catavoicu/Stabilizator-de-tensiune-cu-Element-de-Reglaj-Serie-ERS-/Layout/p1_voicu_catalin.jpg

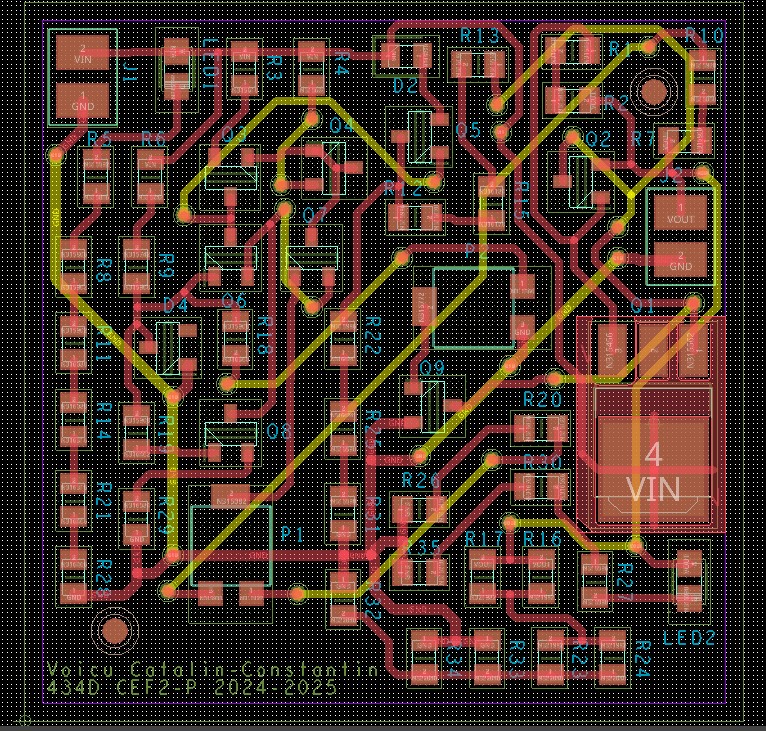
Layout/p1_voicu_catalin.jpg
