catavoicu/Stabilizator-de-tensiune-cu-Element-de-Reglaj-Serie-ERS-/P1_2024_434D_Voicu_Catalin_Constantin_SERS_N28.pptx

## Circuite Electronice Fundamentale 2 – Proiect (CEF2-Pr)

Tema: Stabilizator de tensiune cu Element de Reglaj Serie (ERS)

Student: Voicu Cătălin-Constantin
Grupa 434D

## Date de proiectare

- Tensiunea de ieșire reglabilă în intervalul: 14 - 28 [V]
- Element de reglaj serie;
- Sarcina la ieșire 1120Ω;
- Protecție la suprasarcină prin limitarea temperaturii tranzistorului regulator serie la 120⁰C, și a curentului maxim la 0,5A;
- Tensiune de intrare în intervalul:50,4 - 56 [V]
- Domeniul temperaturilor de funcționare: 0-60 ⁰C (verificabil prin testare în temperatură);
- Dimensiunile PCB: 40mm x 40mm;
- Pentru traseele de interconectare se dau următoarele lăţimi:
  I. Curent de 1A - 26 mil;
  II. Curent de sute de mA - 18 mil;
  III. Semnal - 20 mil.
- Material FR4, dublu strat;

## Schema bloc

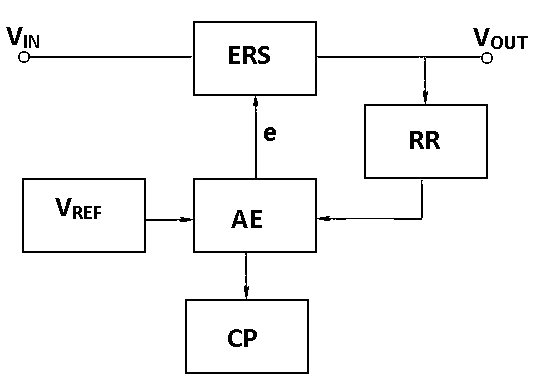
[picture p2: figure]

1. Tensiunea de referință (REF)
2. Amplificatorul de eroare (AE)
3. Elementul de Reglaj Serie (ERS)
4. Rețeaua de reacție (RR)
5. Cicuitele de Protecție (CP)

## Schema electrică

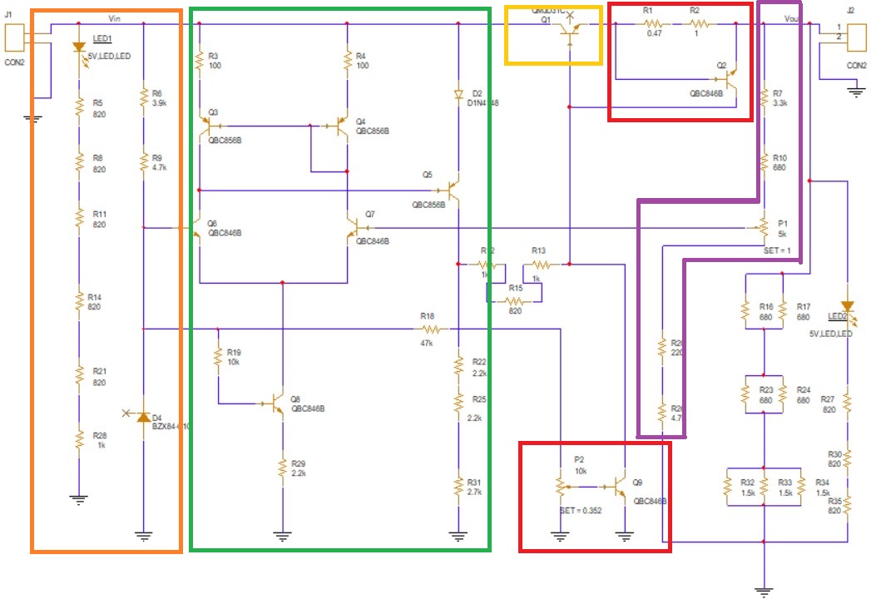
[picture p3: figure]
A diagram of a circuit board

1. Tensiunea de referință (REF)
2. Amplificatorul de eroare (AE)
3. Elementul de Reglaj Serie (ERS)
4. Rețeaua de reacție (RR)
5. Cicuitele de Protecție (CP)

## Simulări

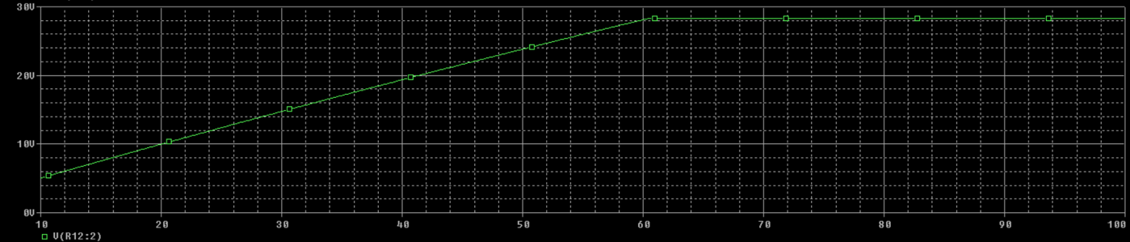
[picture p4: figure]

Caracteristica de ieșire în funcție de tensiunea de intrare

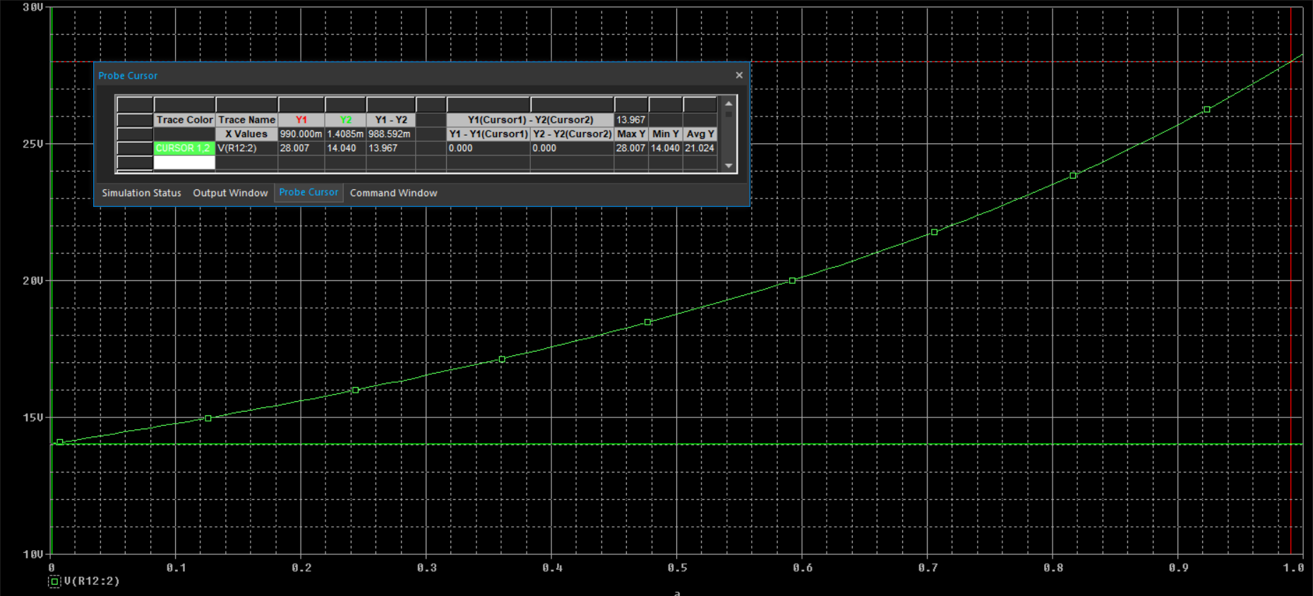
[picture p5: figure]

Caracteristica de ieșire în funcție de poziția potențiometrului

## Simulări

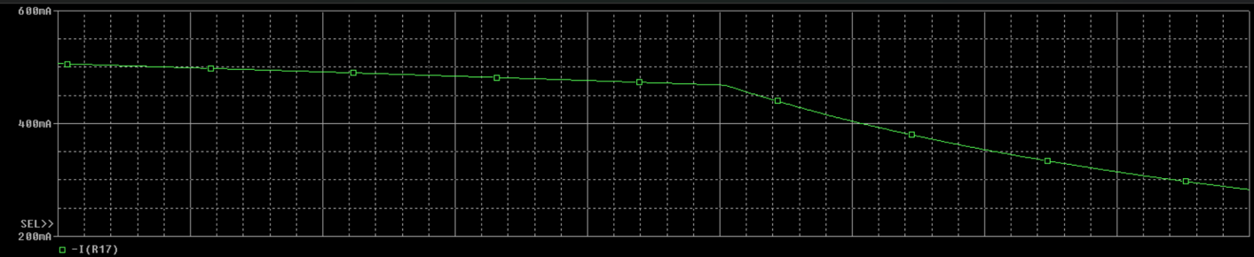
[picture p6: figure]
A graph with green lines

Protecția la suprasarcină

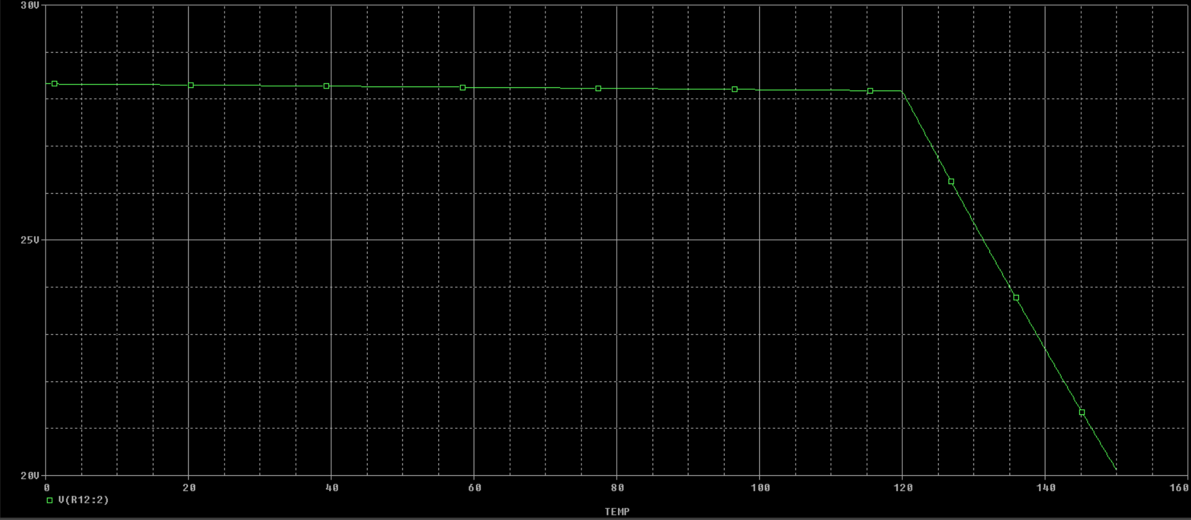
[picture p7: figure]

Protecția la temperatură

## Layout

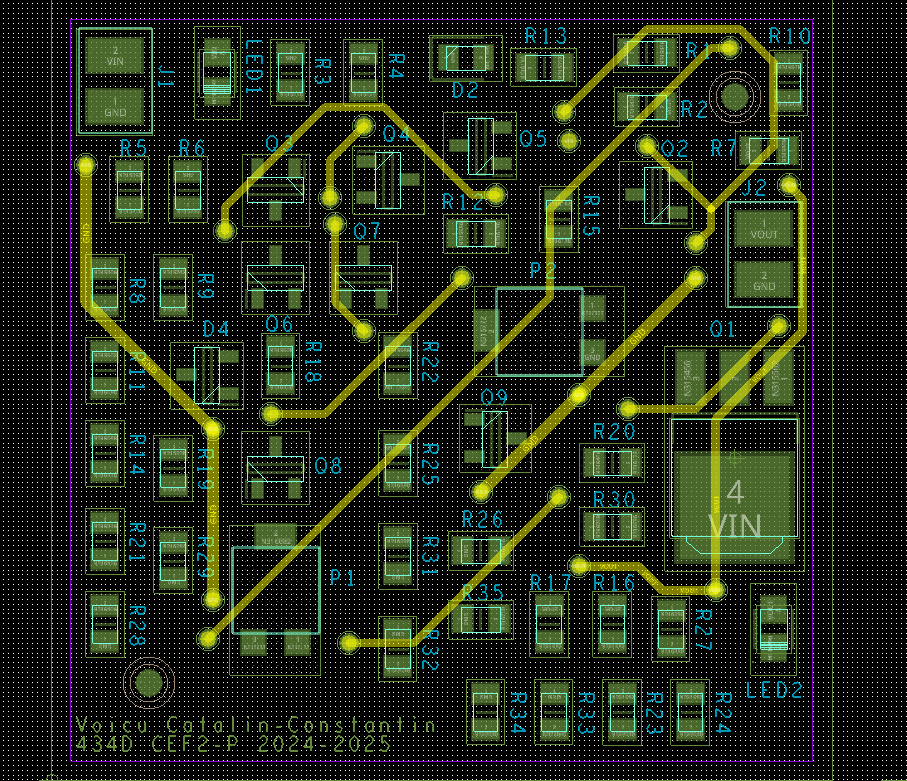
[picture p8: figure]
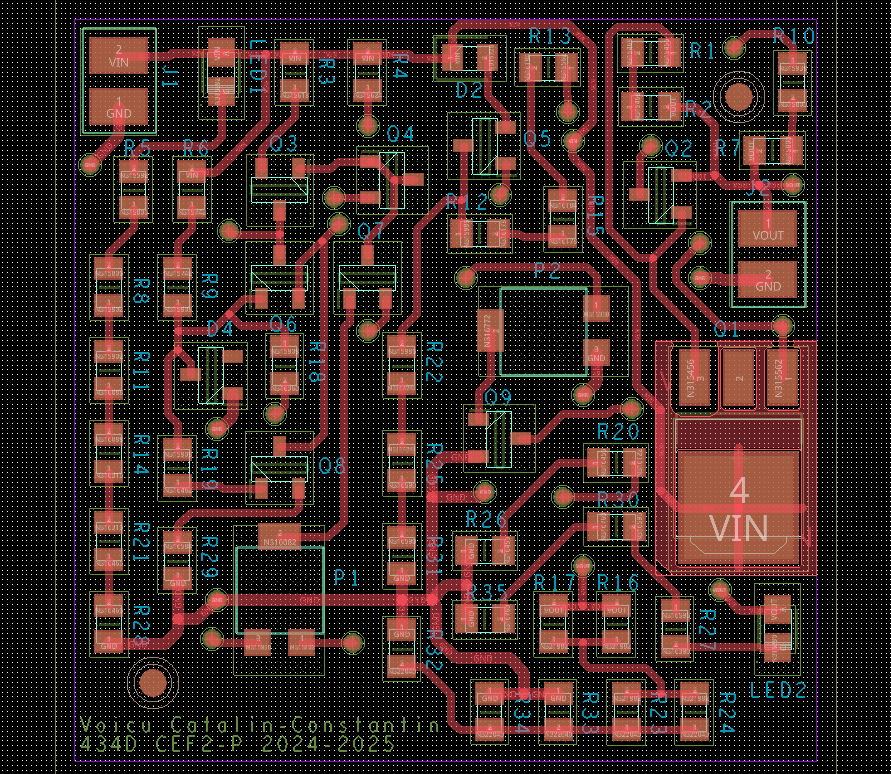
[picture p9: figure]
A computer circuit board with many small colored lines

## Fotografii din etapa de echipare a modulului electronic

- Layout PCB
- Foto PCB echipat
- Maxim o pagină

- se va completa în Sem. al II-lea

## Rezultate experimentale

- Foto forme de undă
- Tabele măsurători
- Tot ceea ce justifică funcționarea proiectului în specificațiile impuse
- Maxim două pagini

- se va completa în Sem. al II-lea

## Rezultate experimentale

- Tabel comparativ

Cerințe impuse | Rezultate simulări | Rezultate măsurători

- se va completa în Sem. al II-lea

## Concluzii

- Se comentează rezultatele obținute
- Ce îmbunătățiri ar putea fi aduse
- În cazul în care proiectul nu a funcționat la prima încercare, se scot în evidență erorile de concept/realizare (d.p.d.v al proiectării schemei, layout-ului, etc. )
- Cum ar putea fi depanat – plan de depanare (organigramă)
- Maxim două pagini
- ! Timpul maxim acordat expunerii este de 5-6 minute

- se va completa în Sem. al II-lea

## Concluzii

- Ce cunoștințe au fost dobândite pe parcursul activităților desfășurate în cadrul proiectului
- Evidențiați, dacă există, părțile bune legate de activitatea depusă și/ sau precizați părțile slabe existente în organizarea desfășurării proiectului
- Care ar fi propunerea voastră, privind modul în care ar trebui să se desfășoare activitățile cerute de proiect, pentru a se asigura finalizarea sa. Prezentați diagrama Gantt corespunzătoare.
- Maxim două pagini
- ! Timpul maxim acordat expunerii este de 5-6 minute

- se va completa în Sem. al II-lea

## Discipline studiate utile în realizarea proiectului

- Se trec disciplinele din care au fost utilizate cunoștințe/informații pentru realizarea proiectului
- Ce discipline, aflate în semestrele din amonte, ar fi trebuit să fie mai bine însușite pentru ușurarea realizării activităților conexe proiectului?

- se va completa în Sem. al II-lea
