catavoicu/Stabilizator-de-tensiune-cu-Element-de-Reglaj-Serie-ERS-/Proiect docs/psf.pdf

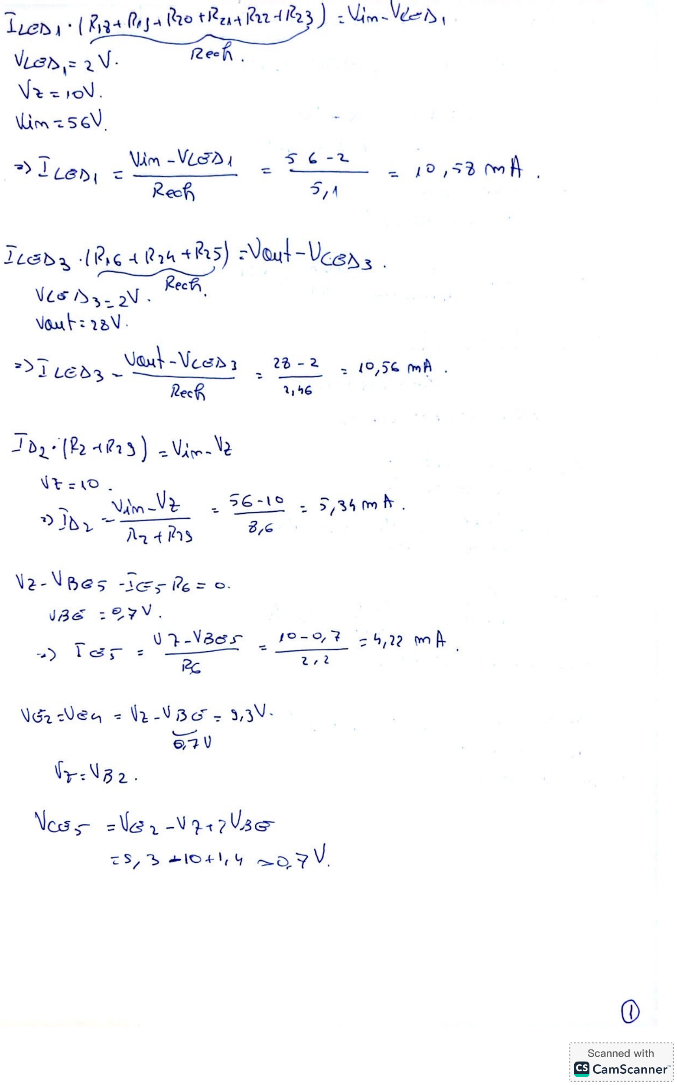
[picture p28: page 1]
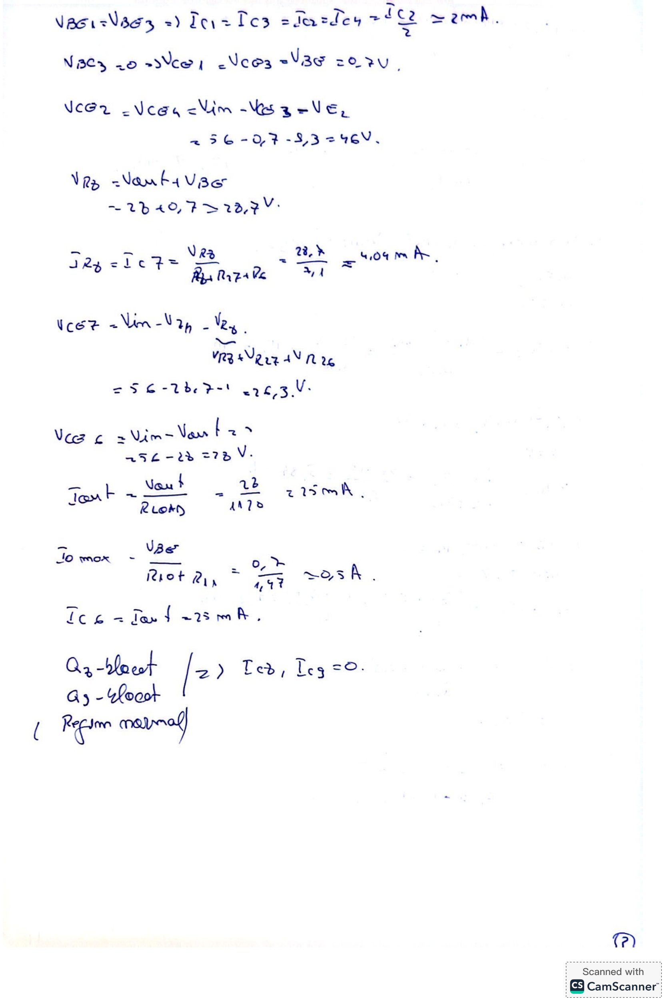
[picture p29: page 2]
