catavoicu/Stabilizator-de-tensiune-cu-Element-de-Reglaj-Serie-ERS-/Schematics/P1_VOICU_CATALIN.jpg

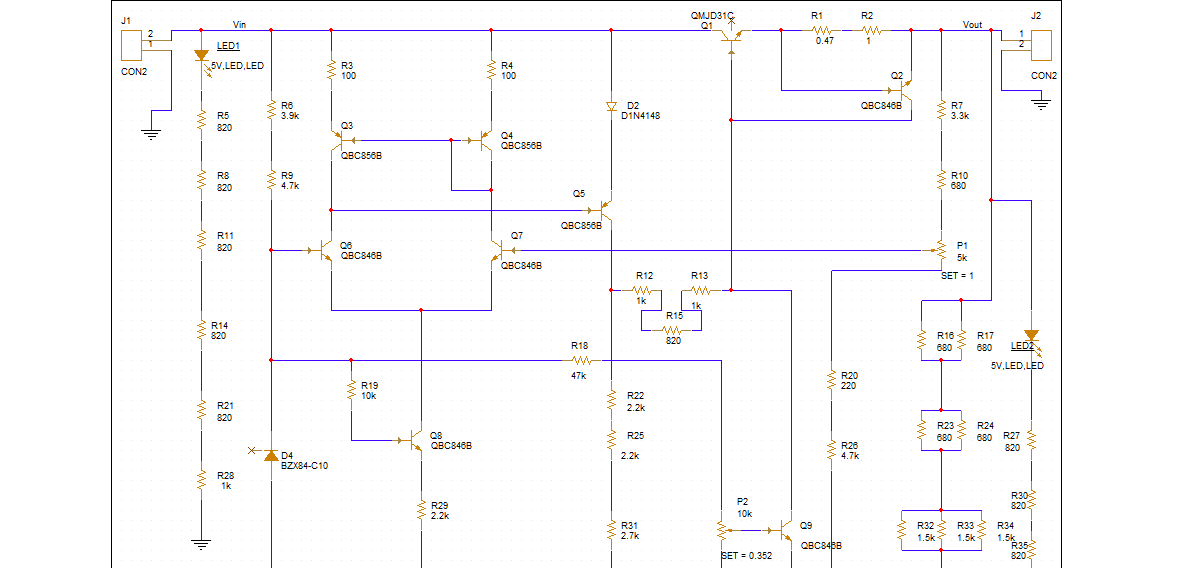
Schematics/P1_VOICU_CATALIN.jpg
