catavoicu/Stabilizator-de-tensiune-cu-Element-de-Reglaj-Serie-ERS-/Schematics/Schema.jpg

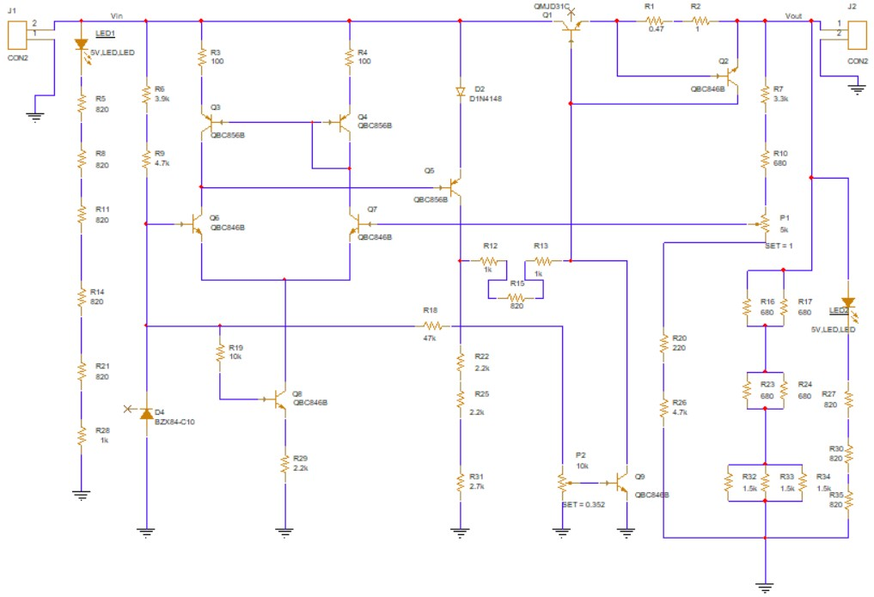
Schematics/Schema.jpg
