catavoicu/Stabilizator-de-tensiune-cu-Element-de-Reglaj-Serie-ERS-/Schematics/Schematics_sapt7/P1_VOICU_CATALIN.png

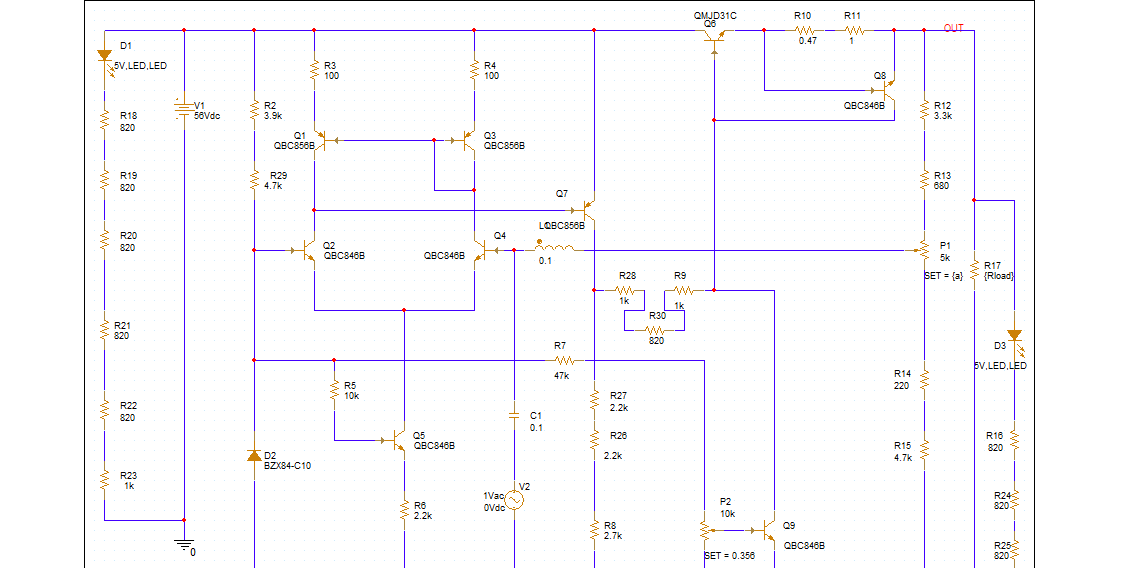
Schematics/Schematics_sapt7/P1_VOICU_CATALIN.png
