catavoicu/Stabilizator-de-tensiune-cu-Element-de-Reglaj-Serie-ERS-/Schematics/Schematics_sapt7/P1_Voicu_Catalin_Constantin.jpg

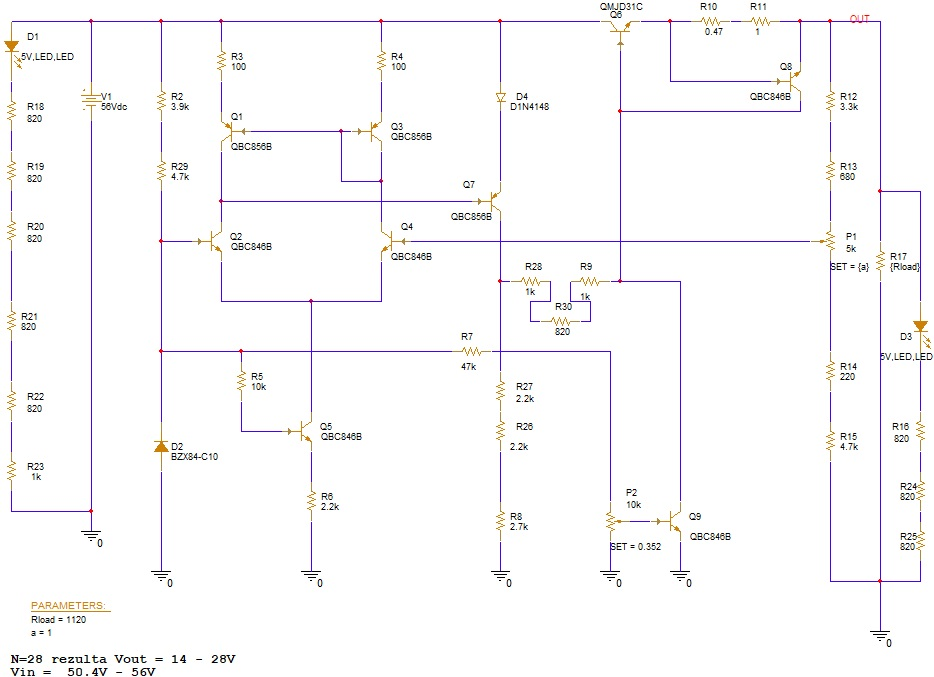
Schematics/Schematics_sapt7/P1_Voicu_Catalin_Constantin.jpg
