catavoicu/Stabilizator-de-tensiune-cu-Element-de-Reglaj-Serie-ERS-/Bill_of_Materials/Anexa_a1_Grupa_434D.xls

Anexa a1 - Grupa 434D - Tema 3 - Stabilizator de tensiune cu ERS
Nr. Crt. | Nume | Catalog | Cod distrib | Nume prod | Prod | Clasă | Qty fix | Qty final | Qty min | Descriere | Distribuitor | Pret (fara TVA) referinta/buc. TME România | Pret total pe reper (fara TVA) - propus
1 | 0 ohm | (LINK) (http://www.tme.eu/ro/details/smd1206-0r/rezistente-smd-1206/royal-ohm/1206s4j0000t5e/) | 1206S4J0000T5E | 1206S4J0000T5E | SR PASSIVES | rezistor | 0 |  |  | Rezistor: thick film; SMD; 1206; 0Ω; 0,25W; ±5%; -55÷125°C | TME România | 0.03841 | 0
2 | 0.47 | (LINK) (http://www.tme.eu/ro/details/smd0805-0r47/rezistente-smd-0805/royal-ohm/0805s8j047kt5e/) | SMD0805-0R47 | 0805S8J047KT5E | ROYAL OHM | rezistor | 20 |  | 1 | Rezistor SMD, chip, 0805, 0.47Ω, ±5%, 0.125W | TME România | 0.01454 | 0.2908
3 | 1 | (LINK) (https://www.tme.eu/ro/details/smd0805-1r/rezistente-smd-0805/royal-ohm/0805s8j010jt5e/) | SMD0805-1R-5% | 0805S8J010JT5E | ROYAL OHM | rezistor | 20 |  | 1 | Rezistor SMD, chip, 0805, 1Ω, ±5%, 0.125W | TME România | 0.01723 | 0.3446
4 | 4.7 | (LINK) (https://www.tme.eu/ro/details/smd0805-4r7/rezistente-smd-0805/royal-ohm/0805s8j047jt5e/) | SMD0805-4R7-5% | 0805S8J047JT5E | ROYAL OHM | rezistor | 10 |  |  | Rezistor SMD, chip, 0805, 4.7Ω, ±5%, 0.125W | TME România | 0.01723 | 0.1723
5 | 10 | (LINK) (https://www.tme.eu/ro/details/smd0805-10r/rezistente-smd-0805/royal-ohm/0805s8j0100t5e/) | SMD0805-10R-5% | 0805S8J0100T5E | ROYAL OHM | rezistor | 10 |  |  | Rezistor SMD, chip, 0805, 10Ω, ±5%, 0.125W | TME România | 0.01723 | 0.1723
6 | 22 | (LINK) (https://www.tme.eu/ro/details/smd0805-22r-1%25/rezistente-smd-0805/royal-ohm/0805s8f220jt5e/) | SMD0805-22R-1% | 0805S8F220JT5E | ROYAL OHM | rezistor | 20 |  |  | Rezistor SMD, chip, 0805, 22Ω, ±1%, 0.125W | TME România | 0.02127 | 0.4254
7 | 33 | (LINK) (https://www.tme.eu/ro/details/smd0805-33r/rezistente-smd-0805/royal-ohm/0805s8j0330t5e/) | SMD0805-33R-5% | 0805S8J0330T5E | ROYAL OHM | rezistor | 20 |  |  | Rezistor SMD, chip, 0805, 33Ω, ±5%, 0.125W | TME România | 0.01723 | 0.3446
8 | 51 | (LINK) (http://www.tme.eu/ro/details/rc0805jr-0751r/rezistente-smd-0805/yageo/rc0805jr-0751rl/) | SMD0805-51R-5% | 0805S8J0510T5E | ROYAL OHM | rezistor | 40 |  |  | Rezistor SMD, chip, 0805, 51Ω, ±5%, 0.125W | TME România | 0.0261 | 1.044
9 | 68 | (LINK) (http://www.tme.eu/ro/details/smd0805-68r-1%25/rezistente-smd-0805/royal-ohm/0805s8f680jt5e/) | SMD0805-68R-1% | 0805S8F680JT5E | ROYAL OHM | rezistor | 10 |  |  | Rezistor SMD, chip, 0805, 68Ω, ±1%, 0.125W | TME România | 0.04662 | 0.4662
10 | 82 | (LINK) (https://www.tme.eu/ro/details/wf08p-82r-5%25/rezistente-smd-0805/walsin/wf08p820jtl/) | SMD0805-82R-5% | WF08P820JTL | WALSIN | rezistor | 20 |  |  | Rezistor SMD, chip, 0805, 82Ω, ±5%, 0.125W | TME România | 0.0172 | 0.344
11 | 100 | (LINK) (https://www.tme.eu/ro/details/smd0805-100r/rezistente-smd-0805/royal-ohm/0805s8j0101t5e/) | SMD0805-100R-5% | 0805S8J0101T5E | ROYAL OHM | rezistor | 60 |  | 2 | Rezistor SMD, chip, 0805, 100Ω, ±5%, 0.125W | TME România | 0.01723 | 1.0338
12 | 150 | (LINK) (https://www.tme.eu/ro/details/smd0805-150r/rezistente-smd-0805/royal-ohm/0805s8j0151t5e/) | SMD0805-150R-5% | 0805S8F1500T5E | ROYAL OHM | rezistor | 30 |  |  | Rezistor SMD, chip, 0805, 150Ω, ±5%, 0.125W | TME România | 0.01723 | 0.5169
13 | 220 | (LINK) (http://www.tme.eu/ro/details/smd0805-220r-1%25/rezistente-smd-0805/royal-ohm/0805s8f2200t5e/) | SMD0805-220R-5% | 0805S8J0221T5E | ROYAL OHM | rezistor | 30 |  | 1 | Rezistor SMD, chip, 0805, 220Ω, ±5%, 0.125W | TME România | 0.02127 | 0.6381
14 | 330 | (LINK) (https://www.tme.eu/ro/details/smd0805-330r/rezistente-smd-0805/royal-ohm/0805s8j0331t5e/) | SMD0805-330R-5% | 0805S8J0331T5E | ROYAL OHM | rezistor | 30 |  |  | Rezistor SMD, chip, 0805, 330Ω, ±5%, 0.125W | TME România | 0.01723 | 0.5169
15 | 470 | (LINK) (https://www.tme.eu/ro/details/smd0805-470r/rezistente-smd-0805/royal-ohm/0805s8j0471t5e/) | SMD0805-470R-5% | 0805S8J0471T5E | ROYAL OHM | rezistor | 30 |  |  | Rezistor SMD, chip, 0805, 470Ω, ±5%, 0.125W | TME România | 0.01723 | 0.5169
16 | 510 | (LINK) (https://www.tme.eu/ro/details/smd0805-510r/rezistente-smd-0805/royal-ohm/0805s8j0511t5e/) | SMD0805-510R-5% | 0805S8J0511T5E | YAGEO | rezistor | 30 |  |  | Rezistor SMD, chip, 0805, 510Ω, ±5%, 0.125W | TME România | 0.01723 | 0.5169
17 | 680 | (LINK) (https://www.tme.eu/ro/details/smd0805-680r/rezistente-smd-0805/royal-ohm/0805s8j0681t5e/) | SMD0805-680R-5% | 0805S8J0681T5E | ROYAL OHM | rezistor | 30 |  | 5 | Rezistor SMD, chip, 0805, 680Ω, ±5%, 0.125W | TME România | 0.01723 | 0.5169
18 | 820 | (LINK) (https://www.tme.eu/ro/details/smd0805-820r/rezistente-smd-0805/royal-ohm/0805s8j0821t5e/) | SMD0805-820R-5% | 0805S8J0821T5E | ROYAL OHM | rezistor | 30 |  | 9 | Rezistor SMD, chip, 0805, 820Ω, ±5%, 0.125W | TME România | 0.01723 | 0.5169
19 | 910 | (LINK) (https://www.tme.eu/ro/details/rc0805jr-07910r/rezistente-smd-0805/yageo/rc0805jr-07910rl/) | SMD0805-910R-5% | RC0805JR-07910RL | YAGEO | rezistor | 40 |  |  | Rezistor SMD, chip, 0805, 910Ω, ±5%, 0.125W | TME România | 0.0261 | 1.044
20 | 1k | (LINK) (https://www.tme.eu/ro/details/smd0805-1k/rezistente-smd-0805/royal-ohm/0805s8j0102t5e/) | SMD0805-1K-5% | 0805S8J0102T5E | ROYAL OHM | rezistor | 100 |  | 3 | Rezistor SMD, chip, 0805, 1kΩ, ±5%, 0.125W | TME România | 0.01723 | 1.723
21 | 1.5k | (LINK) (https://www.tme.eu/ro/details/wf08p-1k5-5%25/rezistente-smd-0805/walsin/wf08p152jtl/) | SMD0805-1K5-5% | WF08P152JTL | WALSIN | rezistor | 40 |  | 3 | Rezistor SMD, chip, 0805, 1.5kΩ, ±5%, 0.125W | TME România | 0.0172 | 0.688
22 | 1.8k | (LINK) (https://www.tme.eu/ro/details/smd0805-1k8/rezistente-smd-0805/royal-ohm/0805s8j0182t5e/) | SMD0805-1K8-5% | 0805S8J0182T5E | ROYAL OHM | rezistor | 30 |  |  | Rezistor SMD, chip, 0805, 1.8kΩ, ±5%, 0.125W | TME România | 0.01723 | 0.5169
23 | 2k | (LINK) (https://www.tme.eu/ro/details/smd0805-2k/rezistente-smd-0805/royal-ohm/0805s8j0202t5e/) | SMD0805-2K-5% | 0805S8J0202T5E | ROYAL OHM | rezistor | 80 |  |  | Rezistor SMD, chip, 0805, 2kΩ, ±5%, 0.125W | TME România | 0.01723 | 1.3784
24 | 2.2k | (LINK) (https://www.tme.eu/ro/details/smd0805-2k2/rezistente-smd-0805/royal-ohm/0805s8j0222t5e/) | SMD0805-2K2-5% | 0805S8J0222T5E | ROYAL OHM | rezistor | 30 |  | 3 | Rezistor SMD, chip, 0805, 2.2kΩ, ±5%, 0.125W | TME România | 0.01723 | 0.5169
25 | 2.7k | (LINK) (https://www.tme.eu/ro/details/smd0805-2k7/rezistente-smd-0805/royal-ohm/0805s8j0272t5e/) | SMD0805-2K7-5% | 0805S8F2701T5E | ROYAL OHM | rezistor | 30 |  | 1 | Rezistor SMD, chip, 0805, 2.7kΩ, ±5%, 0.125W | TME România | 0.01723 | 0.5169
26 | 3.3k | (LINK) (https://www.tme.eu/ro/details/smd0805-3k3/rezistente-smd-0805/royal-ohm/0805s8j0332t5e/) | SMD0805-3K3-5% | 0805S8J0332T5E | ROYAL OHM | rezistor | 20 |  | 1 | Rezistor SMD, chip, 0805, 3.3kΩ, ±5%, 0.125W | TME România | 0.01723 | 0.3446
27 | 3.9k | (LINK) (https://www.tme.eu/ro/details/smd0805-3k9/rezistente-smd-0805/royal-ohm/0805s8j0392t5e/) | SMD0805-3K9-5% | 0805S8J0392T5E | ROYAL OHM | rezistor | 20 |  | 1 | Rezistor SMD, chip, 0805, 3.9kΩ, ±5%, 0.125W | TME România | 0.01723 | 0.3446
28 | 4.7k | (LINK) (https://www.tme.eu/ro/details/smd0805-4k7/rezistente-smd-0805/royal-ohm/0805s8j0472t5e/) | SMD0805-4K7-5% | 0805S8J0472T5E | ROYAL OHM | rezistor | 30 |  | 2 | Rezistor SMD, chip, 0805, 4.7kΩ, ±5%, 0.125W | TME România | 0.01723 | 0.5169
29 | 5.6k | (LINK) (https://www.tme.eu/ro/details/smd0805-5k6/rezistente-smd-0805/royal-ohm/0805s8j0562t5e/) | SMD0805-5K6-5% | 0805S8J0562T5E | ROYAL OHM | rezistor | 40 |  |  | Rezistor SMD, chip, 0805, 5.6kΩ, ±5%, 0.125W | TME România | 0.01723 | 0.6892
30 | 6.8k | (LINK) (https://www.tme.eu/ro/details/rc0805jr-076k8/rezistente-smd-0805/yageo/rc0805jr-076k8l/) | SMD0805-6K8-5% | RC0805JR-076K8L | YAGEO | rezistor | 20 |  |  | Rezistor SMD, chip, 0805, 6.8kΩ, ±5%, 0.125W | TME România | 0.0261 | 0.522
31 | 8.2k | (LINK) (https://www.tme.eu/ro/details/smd0805-8k2/rezistente-smd-0805/royal-ohm/0805s8j0822t5e/) | SMD0805-8K2-5% | 0805S8J0822T5E | ROYAL OHM | rezistor | 30 |  |  | Rezistor SMD, chip, 0805, 8.2kΩ, ±5%, 0.125W | TME România | 0.01723 | 0.5169
32 | 9.1k | (LINK) (https://www.tme.eu/ro/details/smd0805-9k1/rezistente-smd-0805/royal-ohm/0805s8j0912t5e/) | SMD0805-9K1-5% | 0805S8J0912T5E | ROYAL OHM | rezistor | 20 |  |  | Rezistor SMD, chip, 0805, 9.1kΩ, ±5%, 0.125W | TME România | 0.01723 | 0.3446
33 | 10k | (LINK) (https://www.tme.eu/ro/details/smd0805-10k/rezistente-smd-0805/royal-ohm/0805s8j0103t5e/) | SMD0805-10K-5% | 0805S8J0103T5E | ROYAL OHM | rezistor | 100 |  | 1 | Rezistor SMD, chip, 0805, 10kΩ, ±5%, 0.125W | TME România | 0.01723 | 1.723
34 | 15k | (LINK) (https://www.tme.eu/ro/details/smd0805-15k/rezistente-smd-0805/royal-ohm/0805s8j0153t5e/) | SMD0805-15K-5% | 0805S8J0153T5E | ROYAL OHM | rezistor | 30 |  |  | Rezistor SMD, chip, 0805, 15kΩ, ±5%, 0.125W | TME România | 0.01723 | 0.5169
35 | 22k | (LINK) (https://www.tme.eu/ro/details/smd0805-22k/rezistente-smd-0805/royal-ohm/0805s8j0223t5e/) | SMD0805-22K-5% | 0805S8J0223T5E | ROYAL OHM | rezistor | 30 |  |  | Rezistor SMD, chip, 0805, 22kΩ, ±5%, 0.125W | TME România | 0.01723 | 0.5169
36 | 47k | (LINK) (http://www.tme.eu/ro/details/smd0805-47k/rezistente-smd-0805/royal-ohm/0805s8j0473t5e/) | SMD0805-47K-5% | 0805S8J0473T5E | ROYAL OHM | rezistor | 40 |  | 1 | Rezistor: thick film; SMD; 0805; 47kΩ; 0,125W; ±5%; -55÷125°C | TME România | 0.01723 | 0.6892
37 | 68k | (LINK) (https://www.tme.eu/ro/details/smd0805-68k/rezistente-smd-0805/royal-ohm/0805s8j0683t5e/) | SMD0805-68K-5% | 0805S8J0683T5E | ROYAL OHM | rezistor | 20 |  |  | Rezistor SMD, chip, 0805, 68kΩ, ±5%, 0.125W | TME România | 0.01723 | 0.3446
38 | 100k | (LINK) (https://www.tme.eu/ro/details/smd0805-100k/rezistente-smd-0805/royal-ohm/0805s8j0104t5e/) | SMD0805-100K-5% | 0805S8J0104T5E | ROYAL OHM | rezistor | 100 |  |  | Rezistor SMD, chip, 0805, 100kΩ, ±5%, 0.125W | TME România | 0.01723 | 1.723
39 | 150k | (LINK) (http://www.tme.eu/ro/details/smd0805-150k/rezistente-smd-0805/royal-ohm/0805s8j0154t5e/) | SMD0805-150K-5% | 0805S8J0154T5E | ROYAL OHM | rezistor | 30 |  |  | Rezistor SMD, chip, 0805, 150kΩ, ±5%, 0.125W | TME România | 0.01723 | 0.5169
40 | 180k | (LINK) (http://www.tme.eu/ro/details/smd0805-180k/rezistente-smd-0805/royal-ohm/0805s8j0184t5e/) | SMD0805-180K-5% | 0805S8J0184T5E | ROYAL OHM | rezistor | 30 |  |  | Rezistor SMD, chip, 0805, 180kΩ, ±5%, 0.125W | TME România | 0.01723 | 0.5169
41 | 220k | (LINK) (https://www.tme.eu/ro/details/smd0805-220k/rezistente-smd-0805/royal-ohm/0805s8j0224t5e/) | SMD0805-220K-5% | 0805S8J0224T5E | ROYAL OHM | rezistor | 30 |  |  | Rezistor SMD, chip, 0805, 220kΩ, ±5%, 0.125W | TME România | 0.01723 | 0.5169
42 | 330k | (LINK) (https://www.tme.eu/ro/details/smd0805-330k/rezistente-smd-0805/royal-ohm/0805s8j0334t5e/) | SMD0805-330K-5% | 0805S8J0334T5E | ROYAL OHM | rezistor | 30 |  |  | Rezistor SMD, chip, 0805, 330kΩ, ±5%, 0.125W | TME România | 0.01723 | 0.5169
43 | 390k | (LINK) (https://www.tme.eu/ro/details/smd0805-390k/rezistente-smd-0805/royal-ohm/0805s8j0394t5e/) | SMD0805-390K-5% | 0805S8J0394T5E | ROYAL OHM | rezistor | 30 |  |  | Rezistor SMD, chip, 0805, 390kΩ, ±5%, 0.125W | TME România | 0.01723 | 0.5169
44 | 510k | (LINK) (https://www.tme.eu/ro/details/smd0805-510k/rezistente-smd-0805/royal-ohm/0805s8j0514t5e/) | SMD0805-510K-5% | 0805S8J0514T5E | ROYAL OHM | rezistor | 30 |  |  | Rezistor SMD, chip, 0805, 510kΩ, ±5%, 0.125W | TME România | 0.01723 | 0.5169
45 | 1M | (LINK) (https://www.tme.eu/ro/details/crcw08051m00jntabc/rezistente-smd-0805/vishay/) | SMD0805-1M-5% | CRCW08051M00JNTABC | VISHAY | rezistor | 0 |  |  | Rezistor SMD, chip, 0805, 1MΩ, ±5%, 0.125W | TME România | 0.01151 | 0
46 | 2M | (LINK) (http://www.tme.eu/ro/details/smd0805-2m/rezistente-smd-0805/royal-ohm/0805waj-2m-t5e/) | SMD0805-2M7 5% | 0805WAJ 2M T5E | ROYAL OHM | rezistor | 0 |  |  | Rezistor SMD, chip, 0805, 2MΩ, ±1%, 0.125W | TME România | 0.01723 | 0
47 | 5,1M | (LINK) (http://www.tme.eu/ro/details/smd0805-5m1/rezistente-smd-0805/royal-ohm/0805s8j0515t5e/) | SMD0805-5M1 5% | RC0805FR-075M1 | Yageo | rezistor | 0 |  |  | Rezistor SMD, chip, 0805, 5.1MΩ, ±1%, 0.125W | TME România | 0.01723 | 0
48 | 10M | (LINK) (https://www.tme.eu/ro/details/0805s8j0106t5e/rezistente-smd-0805/royal-ohm/) | SMD0805-10M 5% | 0805S8J0106T5E | ROYAL OHM | rezistor | 0 |  |  | Rezistor SMD, chip, 0805, 10MΩ, ±5%, 0.125W | TME România | 0.01723 | 0
49 | 100ohm | (LINK) (https://www.tme.eu/ro/details/ts53yl100r/trimere-smd-cu-o-singura-tura/vishay/ts53yl101mr10/) | 1804GSMD-100R | 1804GSMD-100R | SR PASSIVES | potențiometru | 15 |  |  | Potențiome-tru liniar, simplă tură, SMD, 100Ω, ±10%, 100ppm/°C, 0.25W | TME România | 3.77 | 56.55
50 | 500ohm | (LINK) (https://www.tme.eu/ro/details/ts53yl500r/trimere-smd-cu-o-singura-tura/vishay/ts53yl501mr10/) | 1804GSMD-500R | 1804GSMD-500R | VISHAY | potențiometru | 0 |  |  | Potențiome-tru liniar, simplă tură, SMD, 500Ω, ±10%, 100ppm/°C, 0.25W | TME România | 2.19 | 0
51 | 2k | (LINK) (https://www.tme.eu/ro/details/ts53yl2k/trimere-smd-cu-o-singura-tura/vishay/ts53yl202mr10/) | TS53YL202MR10 | TS53YL202MR10 | VISHAY | potențiometru | 0 |  |  | Potențiome-tru liniar, simplă tură, SMD, 2kΩ, ±20%, 100ppm/°C, 0.25W | TME România | 2.84 | 0
52 | 5k | (LINK) (http://www.tme.eu/ro/details/3314g-1-502e/trimere-smd-cu-o-singura-tura/bourns/) | 3314G-1-502E | 3314G-1-502E | BOURNS | potențiometru | 40 |  | 1 | Potențiome-tru liniar, simplă tură, SMD, 5kΩ, ±20%, 100ppm/°C, 0.25W | TME România | 3.45 | 138
53 | 10k | (LINK) (http://www.tme.eu/ro/details/3314g-1-103e/trimere-smd-cu-o-singura-tura/bourns/) | 3314G-1-103E | 3314G-1-103E | BOURNS | potențiometru | 20 |  | 1 | Potențiome-tru liniar, simplă tură, SMD, 10kΩ, ±20%, 100ppm/°C, 0.25W | TME România | 3.0573 | 61.146
54 | 50k | (LINK) (http://www.tme.eu/ro/details/3314g-1-503e/trimere-smd-cu-o-singura-tura/bourns/) | 3314G-1-503E | 3314G-1-503E | BOURNS | potențiometru | 0 |  |  | Potențiome-tru liniar, simplă tură, SMD, 50kΩ, ±20%, 100ppm/°C, 0.25W | TME România | 2.84 | 0
55 | 100k | (LINK) (http://www.tme.eu/ro/details/ts53yl100k/trimere-smd-cu-o-singura-tura/vishay/ts53yl104mr10/) | TS53YL104MR10 | TS53YL104MR10 | VISHAY | potențiometru | 10 |  |  | Potențiome-tru liniar, simplă tură, SMD, 100kΩ, ±20%, 100ppm/°C, 0.25W | TME România | 2.61 | 26.1
56 | 500k | (LINK) (http://www.tme.eu/ro/details/3314g-1-504e/trimere-smd-cu-o-singura-tura/bourns/) | 3314G-1-504E | 3314G-1-504E | BOURNS | potențiometru | 0 |  |  | Potențiome-tru liniar, simplă tură, SMD, 500kΩ, ±10%, 100ppm/°C, 0.25W | TME România | 2.8802 | 0
 | TOTAL - Componente pasive (rezistoare de valori fixe şi reglabile) |  |  |  |  |  |  |  |  | FARA TVA = | 308.4514 | CU TVA= | 382.479736
57 | 4.7pF | (LINK) (http://www.tme.eu/ro/details/cc0805crnpo94r7/condensatoare-mlcc-smd-0805/yageo/cc0805crnpo9bn4r7/) | CC0805CRNPO9BN4R7 | CC0805CRNPO9BN4R7 | YAGEO | condensator | 20 |  |  | ceramic; MLCC; 4,7pF; 50V; C0G; ±0,25pF; SMD; 0805 | TME România | 0.16643 | 3.3286
58 | 10pF | (LINK) (http://www.tme.eu/ro/details/cc0805jrnpo9100/condensatoare-mlcc-smd-0805/yageo/cc0805jrnpo9bn100/) | CC0805JRNPO9BN100 | CC0805JRNPO9BN100 | YAGEO | condensator | 20 |  |  | ceramic; MLCC; 10pF; 50V; C0G; ±5%; SMD; 0805 | TME România | 0.1649 | 3.298
59 | 47pF | (LINK) (http://www.tme.eu/ro/details/cl21c470jbannnc/condensatoare-mlcc-smd-0805/samsung/) | CL21C470JBANNNC | CL21C470JBANNNC | SAMSUNG | condensator | 20 |  |  | Condensator: ceramic; MLCC; 47pF; 50V; C0G; ±5%; SMD; 0805; -55÷125°C | TME România | 0.11097 | 2.2194
60 | 100pF | (LINK) (http://www.tme.eu/ro/details/cl21c101jbannnc/condensatoare-mlcc-smd-0805/samsung/) | CL21C101JBANNNC | CL21C101JBANNNC | SAMSUNG | condensator | 20 |  |  | Condensator: ceramic; MLCC; 100pF; 50V; C0G; ±5%; SMD; 0805 | TME România | 0.05427 | 1.0854
61 | 470pF | (LINK) (https://www.tme.eu/ro/details/cl21c471jbannnc/condensatoare-mlcc-smd-0805/samsung/) | CL21C471JBANNNC | CL21C471JBANNNC | SAMSUNG | condensator | 20 |  |  | Condensator: ceramic; MLCC; 470pF; 50V; X7R; ±10%; SMD; 0805 | TME România | 0.12123 | 2.4246
62 | 1nF | (LINK) (https://www.tme.eu/ro/details/cc0805jrnpo9102/condensatoare-mlcc-smd/yageo/cc0805jrnpo9bn102/) | CL21C102JBCNNNC | CL21C102JBCNNNC | SAMSUNG | condensator | 0 |  |  | Condensator MLCC, SMD, 0805, 1nF, ±5%, 50V, C0G | TME România | 0.06487 | 0
63 | 2.2nF | (LINK) (https://www.tme.eu/ro/details/cl21b222jbannnc/condensatoare-mlcc-smd-0805/samsung/) | CL21B222JBANNNC | CL21B222JBANNNC | SAMSUNG | condensator | 0 |  |  | Condensator: ceramic; MLCC; 2,2nF; 50V; X7R; ±10%; SMD; 0805 | TME România | 0.1485 | 0
64 | 4.7nF | (LINK) (https://www.tme.eu/ro/details/cl21b472kbannnc/condensatoare-mlcc-smd-0805/samsung/) | CL21B472KBANNNC | CL21B472KBANNNC | SAMSUNG | condensator | 0 |  |  | Condensator MLCC, SMD, 0805, 4.7nF, ±5%, 50V, X7R | TME România | 0.08943 | 0
65 | 5.6nF | (LINK) (https://www.tme.eu/ro/details/cl21b562kbannnc/condensatoare-mlcc-smd-0805/samsung/) | CL21B562KBANNNC | CL21B562KBANNNC | SAMSUNG | condensator | 0 |  |  | Condensator MLCC, SMD, 0805, 5.6nF, ±5%, 50V, X7R | TME România | 0.04517 | 0
66 | 10nF | (LINK) (https://www.tme.eu/ro/details/cl21b103kbannnd/condensatoare-mlcc-smd-0805/samsung/) | CL21B103KBANNND | CL21B103KBANNND | SAMSUNG | condensator | 40 |  |  | Condensator MLCC, SMD, 0805, 10nF, ±5%, 50V, X7R | TME România | 0.06093 | 2.4372
67 | 22nF | (LINK) (http://www.tme.eu/ro/details/cl21b223kcfnnne/condensatoare-mlcc-smd-0805/samsung/) | CL21B223KBANNNC | CL21B223KBANNNC | SAMSUNG | condensator | 0 |  |  | Condensator: ceramic; MLCC; 22nF; 100V; X7R; ±10%; SMD; 0805 | TME România | 0.13823 | 0
68 | 33nF | (LINK) (https://www.tme.eu/ro/details/vj0805y333kxacw1bc/condensatoare-mlcc-smd-0805/vishay/) | VJ0805Y333KXACW1BC | VJ0805Y333KXACW1BC | VISHAY | condensator | 0 |  |  | Condensator: ceramic; MLCC; 33nF; 50V; X7R; ±10%; SMD; 0805 | TME România | 0.05417 | 0
69 | 100nF | (LINK) (https://www.tme.eu/ro/details/cl21b104kbcnnnc/condensatoare-mlcc-smd/samsung/) | CL21B104KBCNNNC | CL21B104KBCNNNC | SAMSUNG | condensator | 40 |  |  | ceramic; MLCC; 100nF; 50V; X7R; ±10%; SMD; 0805 | TME România | 0.3759 | 15.036
70 | 220nF | (LINK) (http://www.tme.eu/ro/details/cl21b224kafnnne/condensatoare-mlcc-smd-0805/samsung/) | CL21B224KAFNNNE | CL21B224KAFNNNE | SAMSUNG | condensator | 0 |  |  | Condensator: ceramic; MLCC; 220nF; 25V; X7R; ±10%; SMD; 0805 | TME România | 0.10247 | 0
71 | 330nF | (LINK) (https://www.tme.eu/ro/details/grm219r71h334ka88d/condensatoare-mlcc-smd-0805/murata/) | GRM219R71H334KA88D | GRM219R71H334KA88D | MURATA | condensator | 0 |  |  | Condensator: ceramic; MLCC; 330nF; 50V; X7R; ±10%; SMD; 0805 | TME România | 0.5972 | 0
72 | 470nF | (LINK) (https://www.tme.eu/ro/details/cc0805mry5v8474/condensatoare-mlcc-smd-0805/yageo/cc0805mry5v8bb474/) | CC0805MRY5V8474 | CC0805MRY5V8BB474 | YAGEO | condensator | 0 |  |  | Condensator: ceramic; MLCC; 470nF; 50V; Y5V; -20÷+80%; SMD; 0805 | TME România | 0.0758 | 0
73 | 1uF | (LINK) (https://www.tme.eu/ro/details/cl21b105kbfnnng/condensatoare-mlcc-smd-0805/samsung/) | CL21B105KBFNNNG | CL21B105KBFNNNG | SAMSUNG | condensator | 20 |  |  | Condensator: ceramic; MLCC; 1uF; 50V; X7R; ±20%; SMD; 0805 | TME România | 0.25253 | 5.0506
74 | 2.2uF | (LINK) (https://www.tme.eu/ro/details/grm21br61h225ka73l/condensatoare-mlcc-smd-0805/murata/) | GRM21BR61H225KA73L | GRM21BR61H225KA73L | MURATA | condensator | 20 |  |  | Condensator: ceramic; MLCC; 2,2uF; 25V; X5R; ±10%; SMD; 0805 | TME România | 0.4486 | 8.972
75 | 4.7uF | (LINK) (https://www.tme.eu/ro/details/cl21a475kaqnnng/condensatoare-mlcc-smd-0805/samsung/) | CL21A475KAQNNNG | CL21A475KAQNNNG | SAMSUNG | condensator | 20 |  |  | ceramic; MLCC; 4,7uF; 25V; X5R; ±10%; SMD; 0805 | TME România | 0.25373 | 5.0746
76 | 10uF | (LINK) (https://www.tme.eu/ro/details/eee1ha100sp/condensatoare-electrolitice-smd/panasonic/) | EEE1HA100SP | EEE1HA100SP | PANASONIC | condensator | 16 |  |  | Condensator: electrolitic; SMD; 10uF; 50V | TME România | 0.2284 | 3.6544
 | TOTAL - Componente pasive (condensatoare) |  |  |  |  |  |  |  |  | FARA TVA = | 52.5808 | CU TVA= | 65.200192
77 | 4148 | (LINK) (http://www.tme.eu/ro/details/1n4148-0805/diode-universale-smd/dc-components/cd4148ws0805c/) | 1N4148-0805 | CD4148WS(0805C) | DC Components | diodă pn | 40 |  | 1 | Diodă comutație, SMD, 0805, 300mA, 100V | TME România | 0.04555 | 1.822
78 | LED | (LINK) (https://www.tme.eu/ro/details/of-smd2012b/diode-led-smd-colorate/optoflash/) | OF-SMD2012B | OF-SMD2012B | OPTOFLASH | LED | 15 |  | 2 | LED albastru, SMD, 0805, 150-200mcd, 476nm, 120° | TME România | 0.1264 | 1.896
79 | 2.7V | (LINK) (https://www.tme.eu/ro/details/bzx84-c2v7.215/diode-zener-smd/nexperia/bzx84-c2v7-215/) | BZX84C2V7 | BZX84-C2V7LT1G | ON Semiconductor | diodă Zener | 5 |  |  | Diodă Zener, SMD, SOT23, 2,7V, ±5%, 0.25W | TME România | 0.05732 | 0.2866
80 | 5.1V | (LINK) (https://www.tme.eu/ro/details/bzx84-c5v1.215/diode-zener-smd/nexperia/) | BZX84C5V1 | BZX84-C5V1 | NEXPERIA | diodă Zener | 10 |  |  | Diodă Zener, SMD, SOT23, 5,1V, ±5%, 0.3W | TME România | 0.06245 | 0.6245
81 | 5.6V | (LINK) (https://www.tme.eu/ro/details/bzx84b5v6-dio/diode-zener-smd/diotec-semiconductor/bzx84b5v6/) | BZX84B5V6 | BZX84B5V6 | DIOTEC SEMICONDUCTOR | diodă Zener | 10 |  |  | Diodă Zener, SMD, SOT23, 5,6V, ±5%, 0.3W | TME România | 0.0839 | 0.839
82 | 6.2V | (LINK) (https://www.tme.eu/ro/details/bzx84-c6v2.215/diode-zener-smd/nexperia/) | BZX84C6V2 | BZX84-C6V2 | NEXPERIA | diodă Zener | 5 |  |  | Diodă Zener, SMD, SOT23, 6.2V, ±5%, 0.3W | TME România | 0.06618 | 0.3309
83 | 6.8V | (LINK) (https://www.tme.eu/ro/details/bzx84-c6v8.215/diode-zener-smd/nexperia/) | BZX84C6V8 | BZX84-C6V8 | NEXPERIA | diodă Zener | 0 |  |  | Diodă Zener, SMD, SOT23, 6.8V, ±5%, 0.3W | TME România | 0.05686 | 0
84 | 8.2V | (LINK) (https://www.tme.eu/ro/details/bzx84-c8v2.215/diode-zener-smd/nexperia/) | BZX84C8V2 | BZX84-C8V2 | NEXPERIA | diodă Zener | 5 |  |  | Diodă Zener, SMD, SOT23, 8.2V, ±5%, 0.3W | TME România | 0.05686 | 0.2843
85 | 10V | (LINK) (https://www.tme.eu/ro/details/bzx84-c10.215/diode-zener-smd/nexperia/) | BZX84C10 | BZX84-C10 | NEXPERIA | diodă Zener | 5 |  | 1 | Diodă Zener, SMD, SOT23, 10V, ±5%, 0.3W | TME România | 0.05686 | 0.2843
86 | PNP | (LINK) (http://www.tme.eu/ro/details/bc856b-dio/tranzistori-smd-pnp/diotec-semiconductor/bc856b/) | BC856B | BC856B | DIOTEC | tranzistor bipolar | 80 |  | 3 | Tranzistor bipolar PNP, SMD, SOT23, 80V, 100mA | TME România | 0.04055 | 3.244
87 | NPN | (LINK) (https://www.tme.eu/ro/details/bc846b-dio/tranzistori-smd-npn/diotec-semiconductor/bc846b/) | BC846B | BC846B | DIOTEC | tranzistor bipolar | 80 |  | 5 | Tranzistor bipolar NPN, SMD, SOT23, 65V, 100mA | TME România | 0.03379 | 2.7032
89 | N-JFET | (LINK) (http://www.tme.eu/ro/details/mmbfj309lt1g/tranzistori-canal-n-smd/on-semiconductor/) | MMBFJ309LT1G | MMBFJ309LT1G | ON Semiconductor | tranzistor NJFET | 40 |  |  | Tranzistor N-JFET, SMD, SOT23, 25V, 30mA | TME România | 0.8063 | 32.252
90 | P-JFET | (LINK) (http://www.tme.eu/ro/details/mmbfj177lt1g/tranzistori-canal-p-smd/on-semiconductor/) | MMBFJ177LT1G | MMBFJ177LT1G | ON Semiconductor | tranzistor PJFET | 15 |  |  | Tranzistor P-JFET, SMD, SOT23, 30V, 20mA | TME România | 0.8808 | 13.212
91 | NPN | (LINK) (http://www.tme.eu/ro/details/bc817-25-dio/tranzistori-smd-npn/diotec-semiconductor/bc817-25/) | BC817-25-DIO | BC817-25-DIO | NXP | tranzistor bipolar | 10 |  |  | Tranzistor bipolar NPN, SMD, SOT23, 45V, 800mA | TME România | 0.0494 | 0.494
93 | PNP | (LINK) (http://www.tme.eu/ro/details/bc807-25-dio/tranzistori-smd-pnp/diotec-semiconductor/bc807-25/) | BC807-25-DIO | BC807-25-DIO | NXP | tranzistor bipolar | 10 |  |  | Tranzistor bipolar PNP, SMD, SOT23, 45V, 800mA | TME România | 0.05406 | 0.5406
94 | NPN | (LINK) (http://www.tme.eu/ro/details/mjd31cg/tranzistori-smd-npn/on-semiconductor/) | MJD31CG | MJD31CG | ON Semiconductor | tranzistor bipolar | 15 |  | 1 | Tranzistor bipolar NPN, SMD, DPACK, 100V, 3A, 15W | TME România | 0.7037 | 10.5555
96 | PNP | (LINK) (http://www.tme.eu/ro/details/mjd32cg/tranzistori-smd-pnp/on-semiconductor/) | MJD32CG | MJD32CG | ON Semiconductor | tranzistor bipolar | 15 |  |  | Tranzistor bipolar PNP, SMD, DPACK, 100V, 3A, 15W | TME România | 0.783 | 11.745
97 | Nmos | (LINK) (http://www.tme.eu/ro/details/irfr120npbf/tranzistori-canal-n-smd/international-rectifier/) | IRFR120NPBF | IRFR120NPBF | International Rectifier | tranzistor NMOS | 10 |  |  | Tranzistor N-MOSFET, SMD, DPAK, 100V, 9.1A, 20V, 39W | TME România | 1.03 | 10.3
 | TOTAL - Componente semiconductoare (tranzistoare bipolare şi cu efect de câmp, diode, LED, etc.) |  |  |  |  |  |  |  |  | FARA TVA = | 118.7139 | CU TVA= | 147.205236
98 | Conn2p | (LINK) (http://www.tme.eu/ro/details/zl301-40p/pini-cu-benzi-si-soclu/ninigi/) | ZL301-40P | ZL301-40P | NINIGI | Sir pini, pas 2,54mm, SMD | 6 |  | 1 | Sir pini, pas 2,54mm, SMD, tip tata, bareta de 40 pini | TME România | 2.3027 | 13.8162
99 | FUSE | (LINK) (http://www.tme.eu/ro/details/3413.0116.11/sigurante-smd-1206-ultrarapide/schurter/) | 3413.0116.11 | 3413.0116.11 | SCHURTER | sigu-ranță | 0 |  |  | Siguranță sticlă, SMD, 1206, 1.25A, 48mΩ | TME România | 0 | 0
 | Total - Conectică, sigurante fuzibile, etc. |  |  |  |  |  |  |  |  | FARA TVA = | 13.8162 | CU TVA= | 17.132088
 | Total general |  |  |  |  |  |  |  |  | FARA TVA = | 493.5623 | CU TVA= | 587.339137
