catavoicu/Stabilizator-de-tensiune-cu-Element-de-Reglaj-Serie-ERS-/Schematics/allegro/MJD31CG.stp

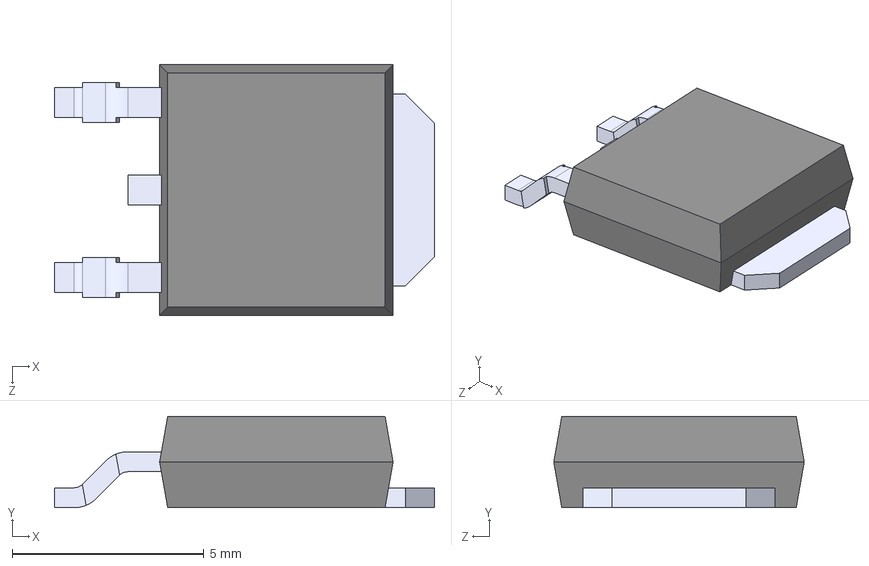
[picture p34: CAD file, 2025-01-25]
Schematics/allegro/MJD31CG.stp
9.92 x 2.39 x 6.54 mm
MAC4DCMT4G_5
MAC4DCMT4G
MAC4DCMT4G_4
MAC4DCMT4G_3
MAC4DCMT4G_2
