catavoicu/Stabilizator-de-tensiune-cu-Element-de-Reglaj-Serie-ERS-/Schematics/allegro/OF-SMD2012B.stp

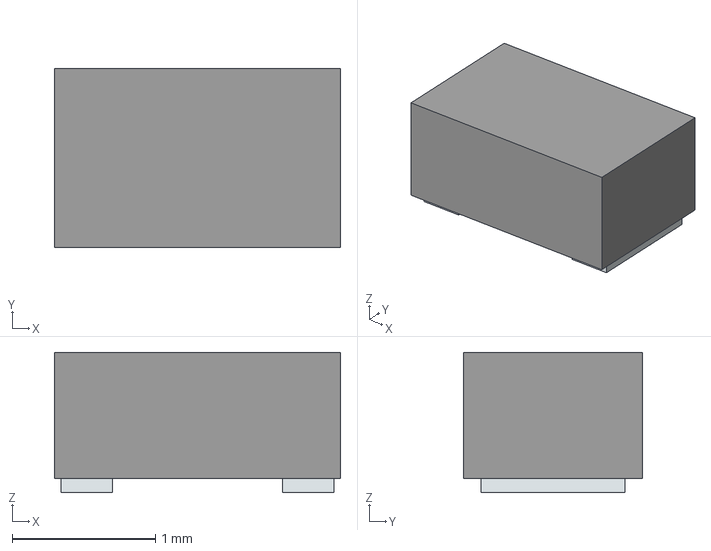
[picture p35: CAD file, 2025-01-25]
Schematics/allegro/OF-SMD2012B.stp
2.00 x 1.25 x 0.98 mm
Pins
