catavoicu/Stabilizator-de-tensiune-cu-Element-de-Reglaj-Serie-ERS-/Schematics/allegro/BC856B.stp

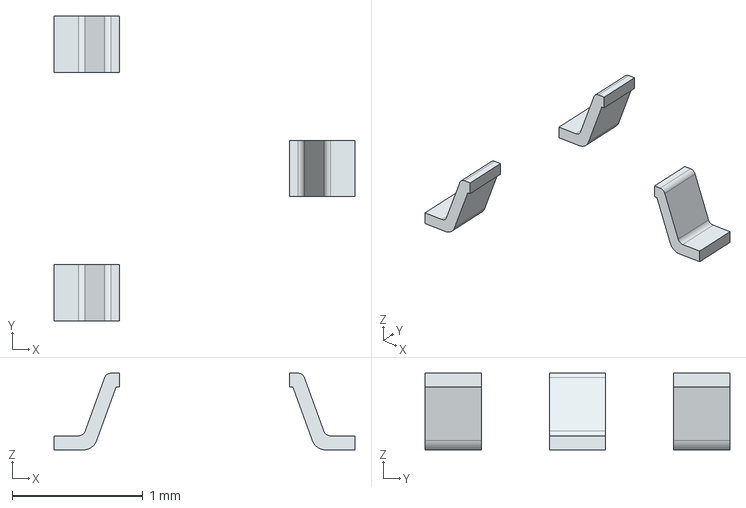
[picture p36: CAD file, 2025-01-25]
Schematics/allegro/BC856B.stp
2.30 x 2.33 x 0.587 mm
PinsArrayL
FilletPinR
