catavoicu/Stabilizator-de-tensiune-cu-Element-de-Reglaj-Serie-ERS-/Schematics/allegro/3314G-1-103E.stp

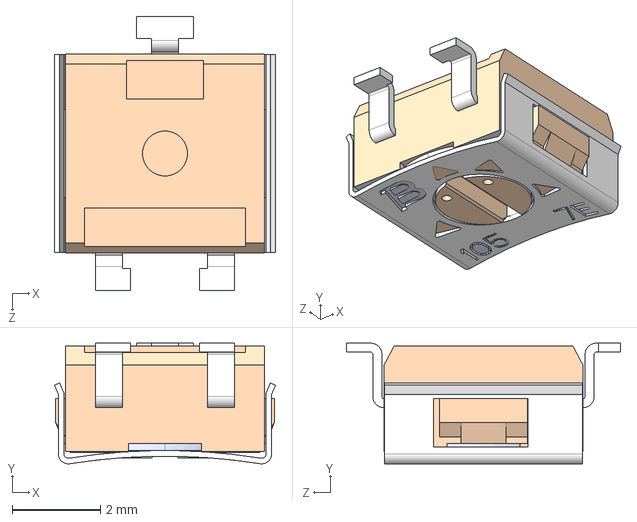
[picture p37: CAD file, 2025-01-25]
Schematics/allegro/3314G-1-103E.stp
5.00 x 2.73 x 6.20 mm
