catavoicu/Stabilizator-de-tensiune-cu-Element-de-Reglaj-Serie-ERS-/Schematics/allegro/0805S8J0472T5E.stp

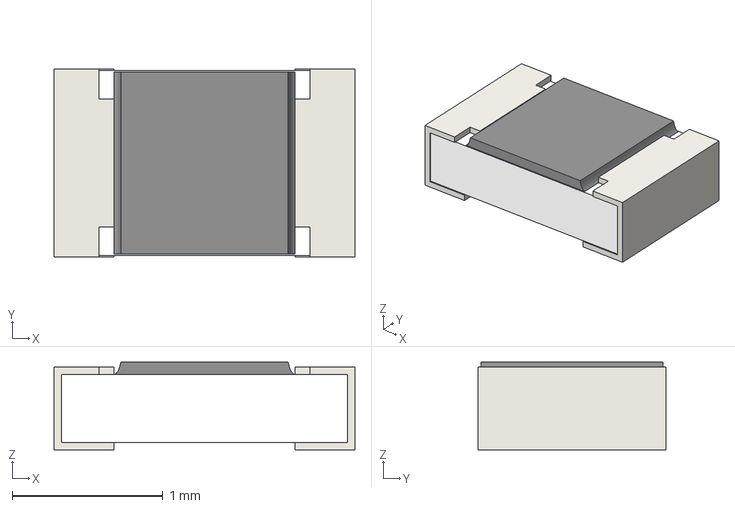
[picture p38: CAD file, 2025-01-25]
Schematics/allegro/0805S8J0472T5E.stp
2.00 x 1.25 x 0.585 mm
