catavoicu/Stabilizator-de-tensiune-cu-Element-de-Reglaj-Serie-ERS-/Schematics/allegro/BC846B.stp

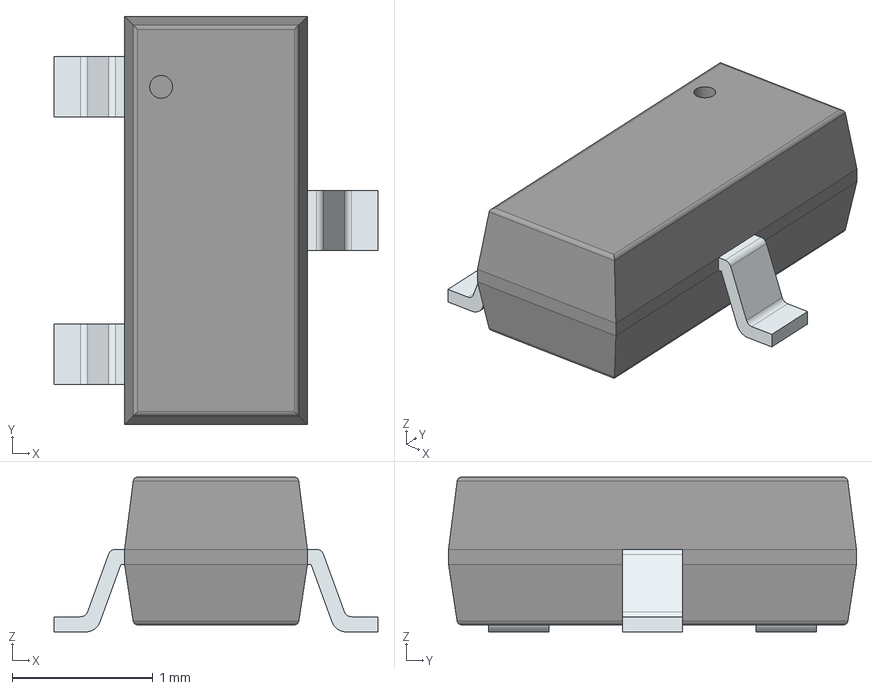
[picture p39: CAD file, 2025-01-25]
Schematics/allegro/BC846B.stp
2.30 x 2.90 x 1.10 mm
PinsArrayL
FilletPinR
