catavoicu/Stabilizator-de-tensiune-cu-Element-de-Reglaj-Serie-ERS-/Schematics/allegro/BZX84-C6V2,215.stp

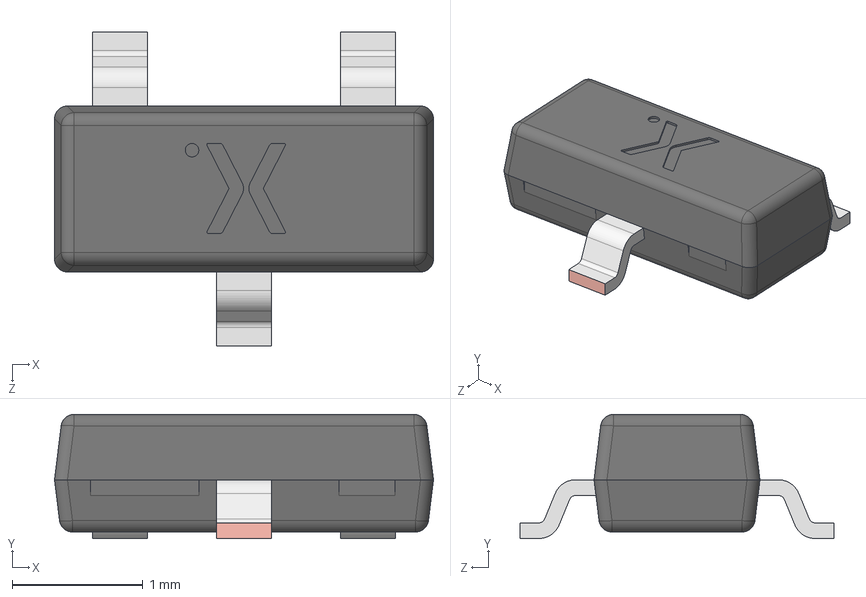
[picture p40: CAD file, 2025-01-25]
Schematics/allegro/BZX84-C6V2,215.stp
2.90 x 0.95 x 2.40 mm
SOT23 lower body
SOT23 Lead x 3
SOT23 Upper body
