catavoicu/Stabilizator-de-tensiune-cu-Element-de-Reglaj-Serie-ERS-/Schematics/allegro/CD4148WS_0805C_.stp

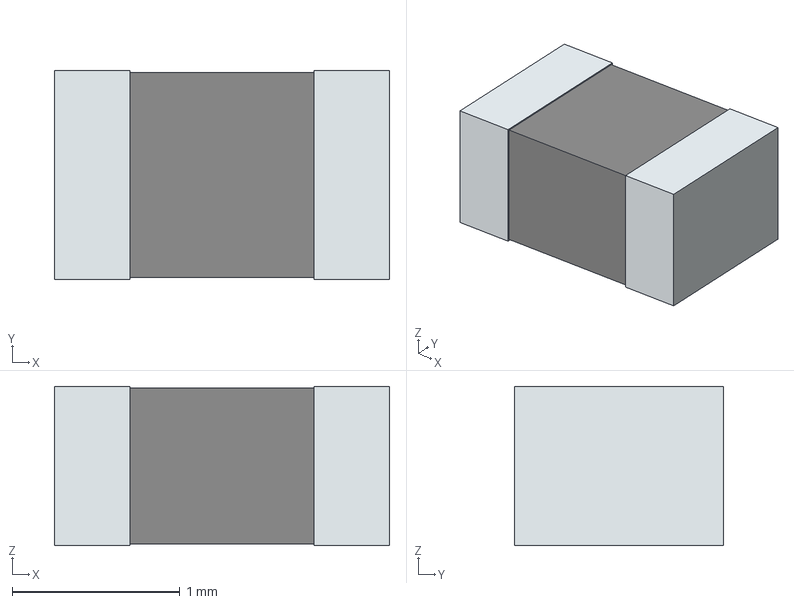
[picture p41: CAD file, 2025-01-25]
Schematics/allegro/CD4148WS_0805C_.stp
2.00 x 1.25 x 0.95 mm
term1
term2
