catavoicu/Stabilizator-de-tensiune-cu-Element-de-Reglaj-Serie-ERS-/(list of files, cad)

Other CAD files:
Schematics/allegro/smr2512.psm
