catavoicu/Stabilizator-de-tensiune-cu-Element-de-Reglaj-Serie-ERS-/Schematics/P1_VOICU_CATALIN-PSpiceFiles/SCHEMATIC1/1/1.cir

** Profile: "SCHEMATIC1-1"  [ C:\Users\catav\OneDrive - Universitatea Politehnica Bucuresti\Desktop\P1\P1_VOICU_CATALIN-PSpiceFiles\SCHEMATIC1\1.sim ] 

** Creating circuit file "1.cir" 
** WARNING: THIS AUTOMATICALLY GENERATED FILE MAY BE OVERWRITTEN BY SUBSEQUENT SIMULATIONS

*Libraries: 
* Profile Libraries :
* Local Libraries :
.LIB "c:/cadence/orcadx_24.1/tools/capture/library/p1/bc807-25.lib" 
.LIB "c:/cadence/orcadx_24.1/tools/capture/library/p1/bc817-25.lib" 
.LIB "c:/cadence/orcadx_24.1/tools/capture/library/p1/bc846b.lib" 
.LIB "c:/cadence/orcadx_24.1/tools/capture/library/p1/bc856b.lib" 
.LIB "c:/cadence/orcadx_24.1/tools/capture/library/p1/bzx84c10.lib" 
.LIB "c:/cadence/orcadx_24.1/tools/capture/library/p1/irfr120npbf.lib" 
.LIB "c:/cadence/orcadx_24.1/tools/capture/library/p1/mjd31cg.lib" 
.LIB "c:/cadence/orcadx_24.1/tools/capture/library/p1/mmbfj177lt1g.lib" 
.LIB "c:/cadence/orcadx_24.1/tools/capture/library/p1/mmbfj309lt1g.lib" 
* From [PSPICE NETLIST] section of C:\Users\catav\AppData\Roaming\SPB_16.6\cdssetup\OrCAD_PSpice\24.1.0\PSpice.ini file:
.lib "nom.lib" 

*Analysis directives: 
.TRAN  0 1000ns 0 
.OPTIONS ADVCONV
.PROBE64 V(alias(*)) I(alias(*)) W(alias(*)) D(alias(*)) NOISE(alias(*)) 
.INC "..\SCHEMATIC1.net" 


.END
