catavoicu/Stabilizator-de-tensiune-cu-Element-de-Reglaj-Serie-ERS-/(list of files, drawings)

Other design files:
Schematics/P1_VOICU_CATALIN.DSN
Schematics/P1_VOICU_CATALIN.opj
Schematics/Schematics_sapt7/P1_VOICU_CATALIN.DSN
Schematics/Schematics_sapt7/P1_VOICU_CATALIN.opj
